Kokovec/SID_Player_Dan/docs/affbe422-2d53-4fc4-84e7-3da24a6594be.__CR0,0,1464,600_PT0_SX1464_V1___.jpg

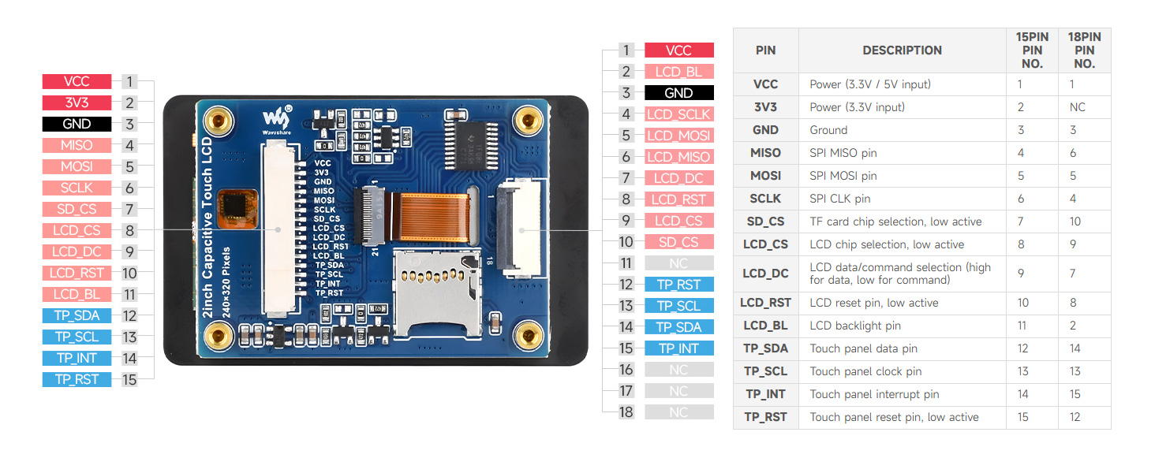
docs/affbe422-2d53-4fc4-84e7-3da24a6594be.__CR0,0,1464,600_PT0_SX1464_V1___.jpg
