Kokovec/SID_Player_Dan/docs/IMG_8419.JPEG

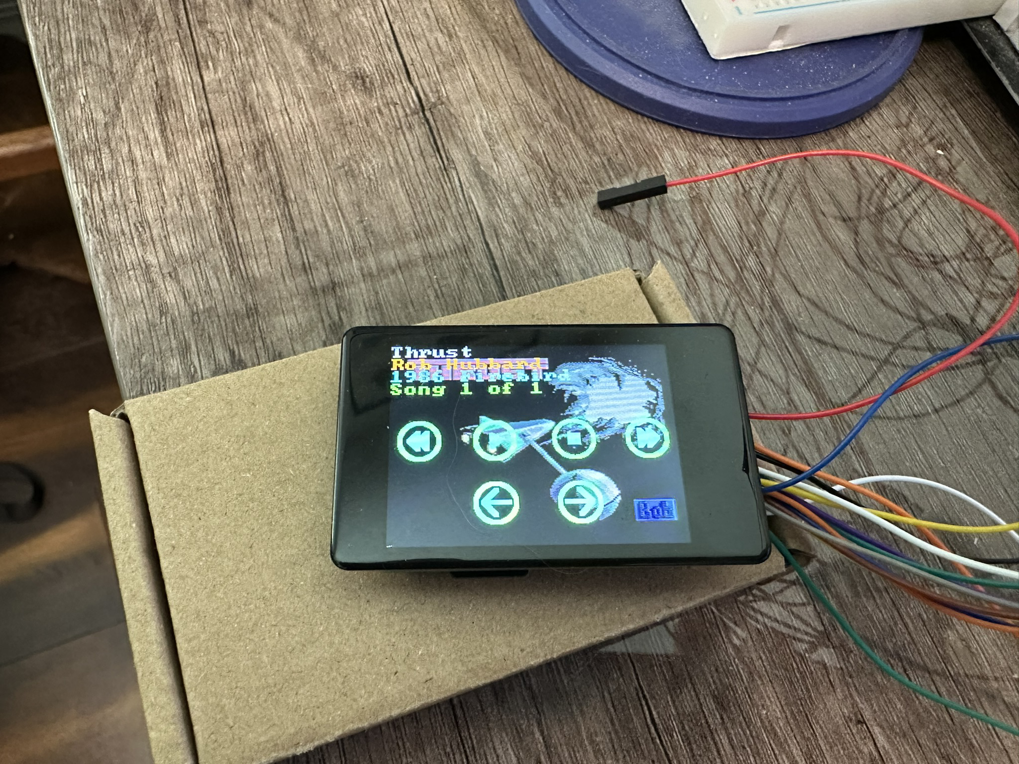
docs/IMG_8419.JPEG
