Kokovec/SID_Player_Dan/docs/Schematic.pdf

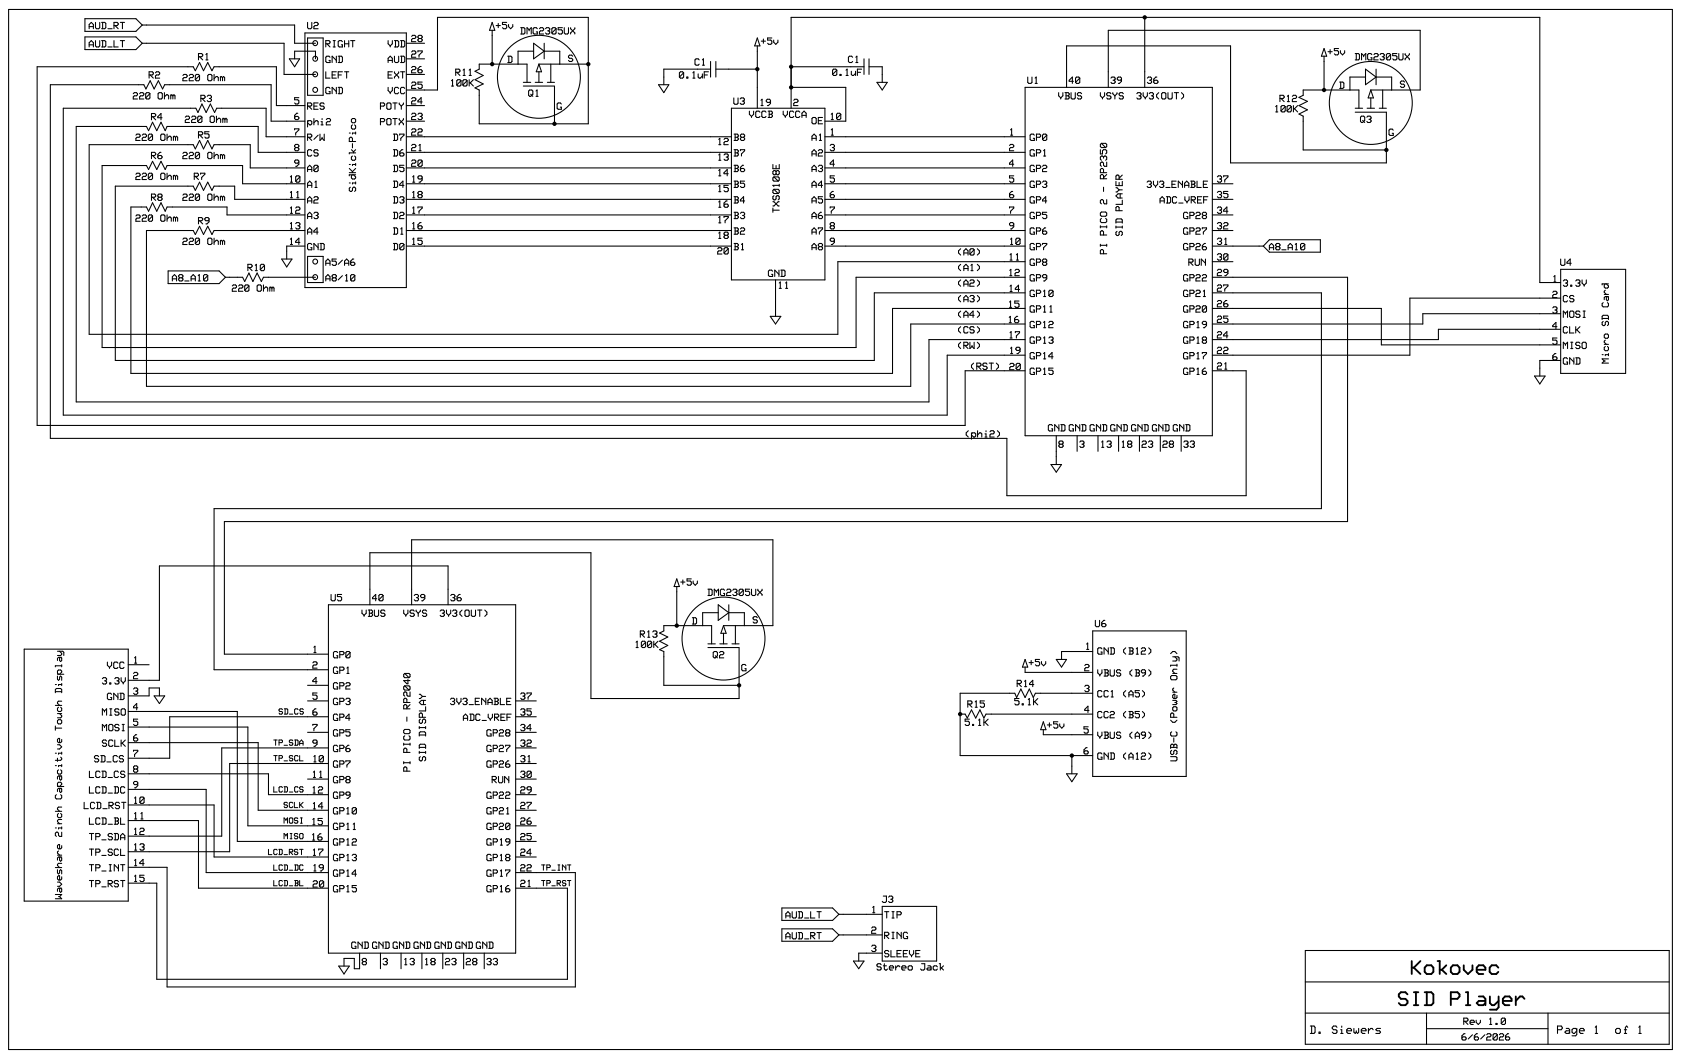
[picture p7: page 1]
