Kokovec/SID_Player_Dan/(commit log)

2026-05-23 Working SID player: SD card, button skip, PAL/NTSC clock, 6502 emulation
    - Reads .sid files from SD card root (GP17-20, SPI0)
    - phi2 clock via PWM on GP16 (PAL 985kHz / NTSC 1.023MHz)
    - 6502 INIT+PLAY loop with sentinel-based call_routine
    - Next-track button on GP22 (active low); wraps after last file
    - Fixes: init_addr=0 uses load_addr per PSID spec; SP restored on
    call_routine safety-limit exit
    [SID_Player_Dan.c, hw_config.c, sid_types.h]
2026-05-23 Track lib and vscode settings; ignore .claude and old delta_sid template
2026-05-23 fixed the tft.c file to work with the new display driver
2026-05-25 Added support for the new RSID format. Also added a new function to get the current RSID position, which can be used for syncing visuals with the music.
2026-05-25 Add hardware connection details to README
    Added pinout information for SIDKick Pico, SD Card, TFT Display, and Button.
2026-05-25 Convert README to HTML format with styles
    Added HTML structure and styling for SID Player Pico pinouts.
2026-05-25 Update GPIO table with physical pin connections
2026-05-25 Add unused GPIO pin GP21 to README
2026-06-01 Update README with SID pin connections and details
2026-06-01 Add Pi Pico 2 pinout section to README
2026-06-03 Update Pi Pico 2 pinout and SID pin descriptions
2026-06-06 added feature to read the sidkick-pico config registers
2026-06-06 Add 2SID stereo support and robust SIDKick config read/write
    Configure the SIDKick-Pico per tune: filenames containing "2SID" get a
    stereo-centred profile (SID2 8580 @ $D500, centred panning), others get
    mono (SID2 disabled). Clock field tracks the SID header's PAL/NTSC.
    Config bus access (TXS0108E level shifter required — the TXB0108's weak
    drivers corrupt the fast-changing bus):
    - Reads: validate-and-retry the whole session; the first config session
    after a cold boot often fails to engage.
    - Writes: establish config mode with an in-session read probe, then write
    in that same session and apply live (0xFE, no flash) — cold writes only
    take once config mode is genuinely engaged.
    S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
    [SID_Player_Dan.c]
2026-06-06 Harden SIDKick config read for cold start; never apply on read failure
    The boot-time config read could fail to engage on a truly cold SIDKick
    (returning all 0xFF), and apply_profile then wrote that garbage back and
    applied it live — misconfiguring the SID so no tune would play.
    - sidkick_read_config now establishes config mode in-session (re-enter on a
    stable slow clock until a probe read returns a real config byte) instead of
    cycling the clock between attempts, wrapped in the existing validate-retry.
    It returns bool (false if it never engages).
    - sidkick_apply_profile bails out and leaves the SIDKick config untouched if
    the read fails, so a read hiccup can no longer kill playback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
    [SID_Player_Dan.c]
2026-06-06 Add image to README for SIDkick Pico DAC
2026-06-07 Adda ability to change tune track
    [Sid_Player.sch]
2026-06-07 Fixed a bug where reading the config registers would hang the Sidkick. The problem was that the config registers were not being cleared after being read, so the Sidkick would keep trying to read them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
    [SID_Player_Dan.c]
2026-06-12 Fixed CIA-timed PSID poll rate calculation.
    [Sid_Player.sch]
2026-06-12 Remove product page link from README
    Removed product page link for the 2-inch capacitive touch LCD.
2026-06-14 Fix SIDKick going deaf when a quick-INIT tune is the first played
    A config read leaves the SIDKick in config mode for ~25 ms. A tune whose
    INIT is tiny (e.g. C64_DTV_Menu, which just sets the CIA timer and returns)
    starts playing inside that window, and its first SID writes during config
    mode wedge the SIDKick deaf until a 5 V power cycle. Tunes with longer INITs
    survive because config mode expires first.
    - sidkick_apply_profile now seeds last_profile to mono-PAL (the SIDKick's
    boot flash default), so a mono-PAL first tune does NO config read at all and
    never plays right after a config access.
    - After any real config read/write, wait 50 ms so config mode expires before
    playback begins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
    [SID_Player_Dan.c]
2026-06-18 Added files to the docs folder
    [Power.sch, Sid_Player.sch]
2026-06-18 Update schematic image reference in README.md
2026-06-20 Added blinkind comms LED, fixed bug while selecting subtunes
    [SID_Player_Dan.c]
